sudoDeVinci/Cloud-Imager-VLSP/docs/pattern.png

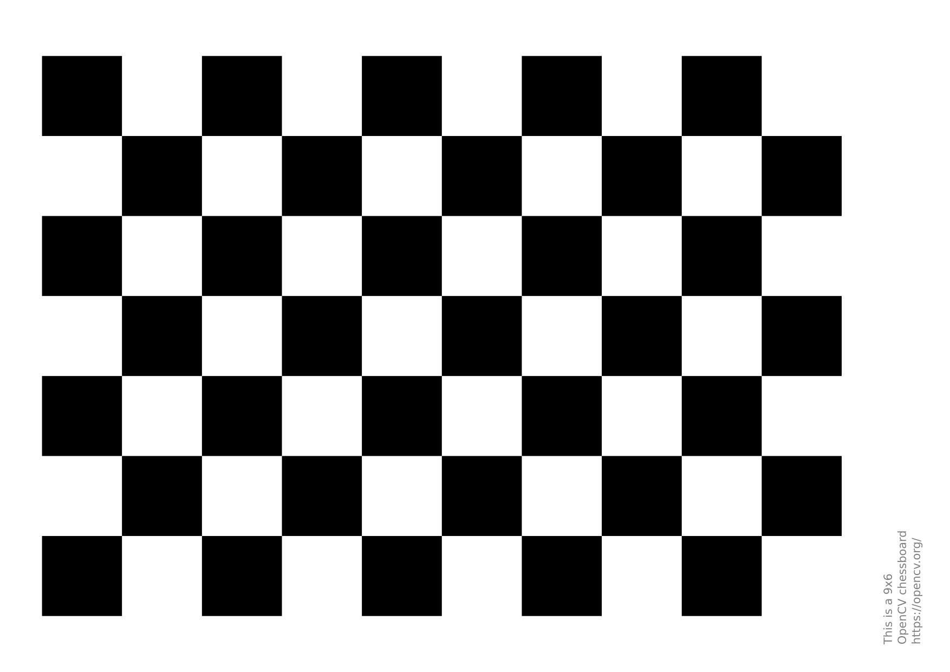
docs/pattern.png
