sudoDeVinci/Cloud-Imager-VLSP/Graphs/BGRPcaGraph-esp.png

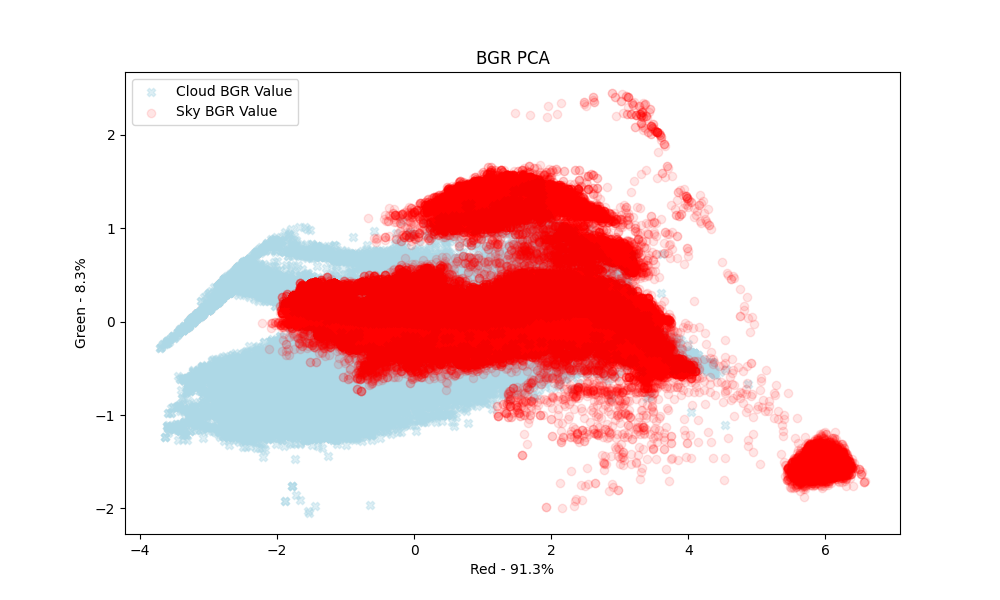
Graphs/BGRPcaGraph-esp.png
