sudoDeVinci/Cloud-Imager-VLSP/Graphs/BGRPcaGraph.png

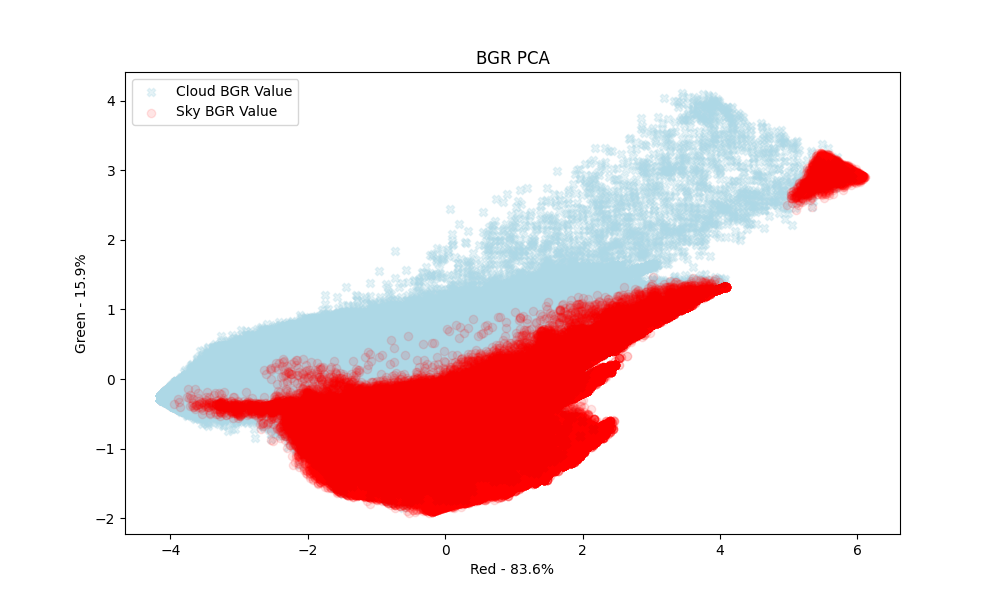
Graphs/BGRPcaGraph.png
