sudoDeVinci/Cloud-Imager-VLSP/Graphs/HSVBarGraph.png

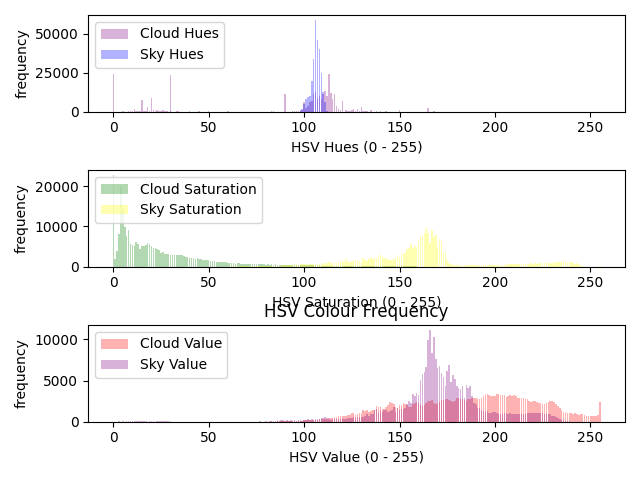
Graphs/HSVBarGraph.png
