sudoDeVinci/Cloud-Imager-VLSP/Graphs/HSVPcaGraph-esp.png

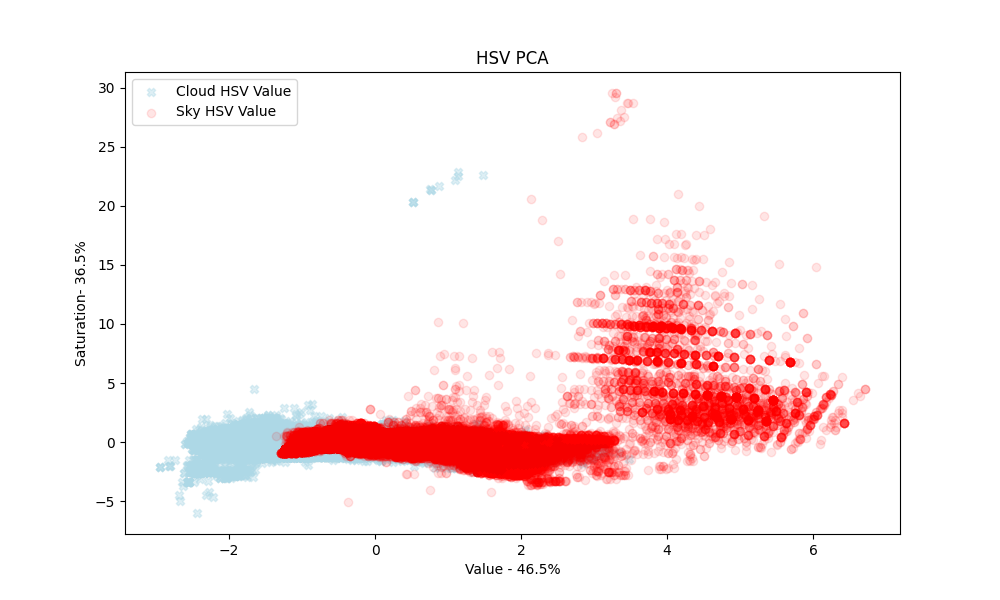
Graphs/HSVPcaGraph-esp.png
