sudoDeVinci/Cloud-Imager-VLSP/Graphs/HSVPcaGraph.png

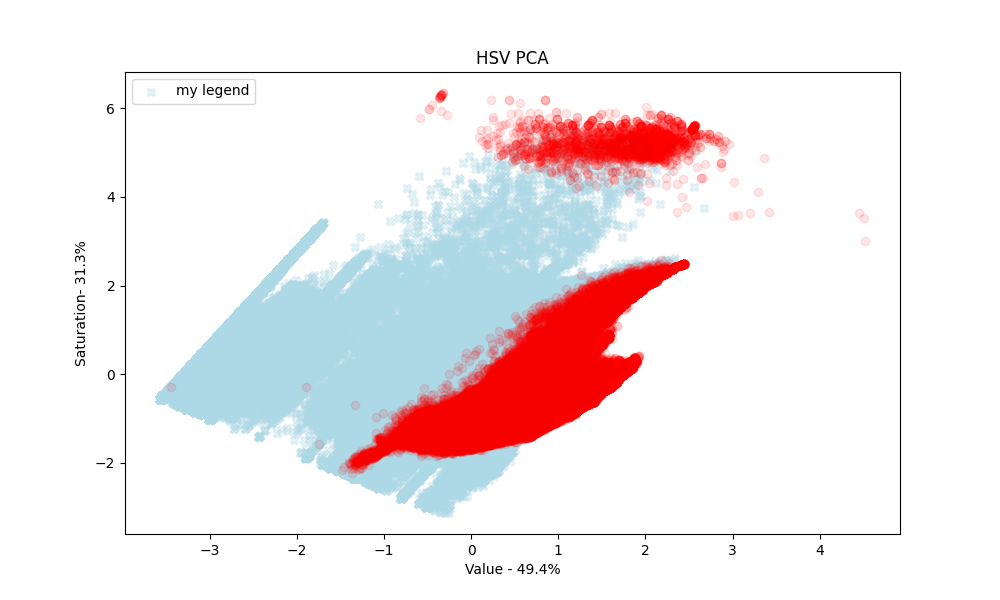
Graphs/HSVPcaGraph.png
