sudoDeVinci/Cloud-Imager-VLSP/Graphs/HSVScree-esp.png

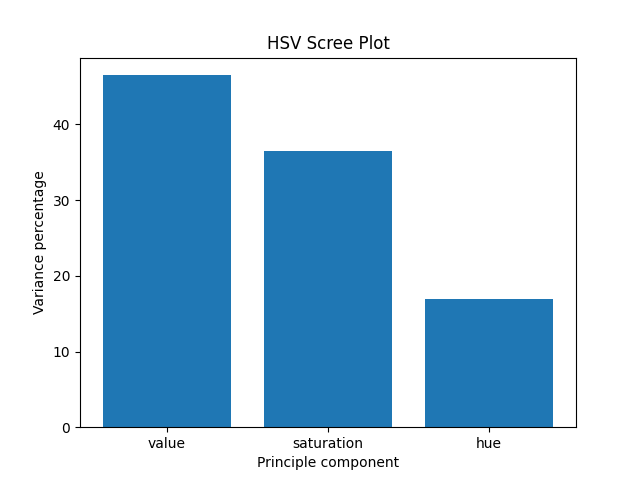
Graphs/HSVScree-esp.png
