sudoDeVinci/Cloud-Imager-VLSP/Graphs/HSVScree.png

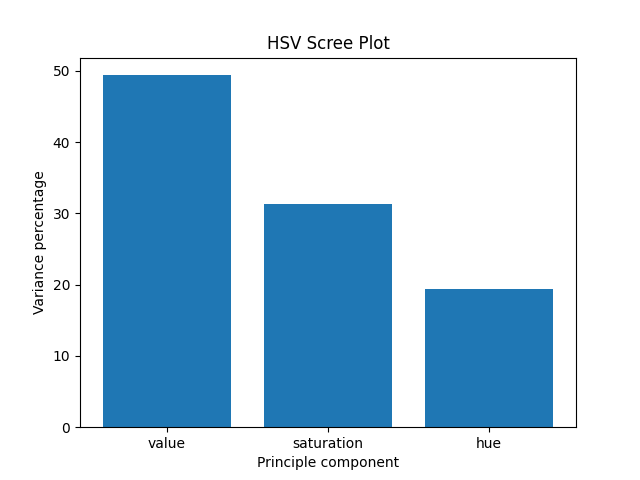
Graphs/HSVScree.png
