sudoDeVinci/Cloud-Imager-VLSP/onboard/sensors.cpp

#include "sensors.h"
#include "camera_pins.h"

float SEALEVELPRESSURE_HPA = UNDEFINED;

/**
 * Calculate the median of a sorted array.
 */
float median(float* sortedArray, int size) {
  if (size % 2 == 0) return (sortedArray[size / 2 - 1] + sortedArray[size / 2]) / 2.0;
  else return sortedArray[size / 2];
}

/**
 * Calculate mean of float array after removing outliers via IQR.
 */
float removeOutliersAndGetMean(float* dataArray, int dataSize) {
  // Sort the array
  float sortedData[dataSize];
  memcpy(sortedData, dataArray, dataSize * sizeof(float));
  std::sort(sortedData, sortedData + dataSize);

  // Calculate Q1 and Q3
  int Q1_index = dataSize / 4;
  int Q3_index = (3 * dataSize) / 4;
  float Q1 = median(sortedData, Q1_index == 0 ? 1 : Q1_index);
  float Q3 = median(sortedData + Q3_index, dataSize - Q3_index);

  // Calculate IQR
  float IQR = Q3 - Q1;

  // Define the lower and upper bounds for outliers
  float lowerBound = Q1 - 1.5 * IQR;
  float upperBound = Q3 + 1.5 * IQR;

  float sum = 0.0;
  int validCount = 0;

  // Calculate mean of non-outlier values
  for (int i = 0; i < dataSize; i++) {
    if (dataArray[i] >= lowerBound && dataArray[i] <= upperBound) {
      sum += dataArray[i];
      validCount++;
    }
  }

  return sum / validCount;
}

/**
 * Sleep for a specified number of minutes. 
 */
void deepSleepMins(float mins) {
  esp_sleep_enable_timer_wakeup(mins*60000000);
  esp_deep_sleep_start();
}

/**
 * Toggle the heater for the SHT31-D.
 */
void toggleHeater(Sensors::Status *stat, Adafruit_SHT31 *sht) {
  if(stat -> SHT) sht -> heater(!(sht -> isHeaterEnabled()));
}

/**
 * Setup the SHT31-D.
 */
void shtSetup(Sensors::Status *stat, Adafruit_SHT31 *sht) {
  if (!sht -> begin()) {
    stat -> SHT = false;
    if (sht -> isHeaterEnabled()) toggleHeater(stat, sht);
    debugln("Couldn't find SHT31");
  } else {
    stat -> SHT = true;
    debugln("SHT31 found!");
  }
}

/**
 * Setup and calibrate the BMP390.
 */
void bmpSetup(TwoWire *wire, Sensors::Status *stat, Adafruit_BMP3XX *bmp) {
  
  if (!bmp -> begin_I2C(0x77, wire)) {
    stat -> BMP = false;
    debugln("Couldn't find BMP390");
  } else {
    stat -> BMP = true;
    debugln("BMP found!");

    /**
     * Set up oversampling and filter initialization
     */
    bmp -> setTemperatureOversampling(BMP3_OVERSAMPLING_32X);
    bmp -> setPressureOversampling(BMP3_OVERSAMPLING_32X);
    bmp -> setIIRFilterCoeff(BMP3_IIR_FILTER_COEFF_127);
    bmp -> setOutputDataRate(BMP3_ODR_50_HZ);
  }
}

/**
 * Reset the display and set the text color to white.
 */
void resetDisplay(Adafruit_SSD1306 *display) {
  display -> clearDisplay();
  display -> setTextSize(1.75);
  display -> setTextColor(WHITE);
}

/**
 * Setup and calibrate the SSD1306 OLED.
 */
void displaySetup(Sensors::Status *stat, Adafruit_SSD1306 *display) {
  if (!display -> begin(SSD1306_SWITCHCAPVCC, 0x3C)) {
    debugln("Display allocation failed");
  } else {
    stat -> SCREEN = true;
    resetDisplay(display);
    debugln("Display Found!");
    display -> println("Welcome!");
    display -> display(); 
  }

}

/**
 * Display the readings on the OLED display.
 */
void displayReadings(Reading* readings, Adafruit_SSD1306 *display) {

  display -> setTextColor(WHITE, BLACK);

  display -> setCursor(50, 10);
  display -> println(readings -> temperature + " C");

  display -> setCursor(50, 22);
  display -> println(readings -> humidity + " %");

  display -> setCursor(50, 34);
  display -> println(readings -> pressure + " Pa");

  display -> setCursor(50, 46);
  display -> println(readings -> dewpoint + " C");

  display -> display();
}


/**
 * Show the status of the sensprs on the OLED display.
 */
void displayStatuses(Sensors::Status *stat, Adafruit_SSD1306 *display, const char* SSID) {
  if (!stat -> SCREEN) return ;

  display -> setTextSize(1.8);

  display -> setCursor(0, 10);
  if (stat -> BMP) display -> setTextColor(BLACK, WHITE);
  else display -> setTextColor(WHITE, BLACK);
  display -> println(" BMP ");
  display -> display();

  display -> setCursor(0, 22);
  if (stat -> SHT) display -> setTextColor(BLACK, WHITE);
  else display -> setTextColor(WHITE, BLACK);
  display -> println(" SHT ");
  display -> display();

  display -> setCursor(0, 34);
  if (stat -> CAM) display -> setTextColor(BLACK, WHITE);
  else display -> setTextColor(WHITE, BLACK);
  display -> println(" CAM ");
  display -> display();

  display -> setCursor(0, 46);
  if (stat -> WIFI) display -> setTextColor(BLACK, WHITE);
  else display -> setTextColor(WHITE, BLACK);
  display -> println(" WIFI");
  display -> display();
}


/**
 * Set up the camera. 
 */
void cameraSetup(Sensors::Status *stat) {

  debugln("Setting up camera...");

  camera_config_t config;
  config.ledc_channel = LEDC_CHANNEL_0;
  config.ledc_timer = LEDC_TIMER_0;
  config.pin_d0 = Y2_GPIO_NUM;
  config.pin_d1 = Y3_GPIO_NUM;
  config.pin_d2 = Y4_GPIO_NUM;
  config.pin_d3 = Y5_GPIO_NUM;
  config.pin_d4 = Y6_GPIO_NUM;
  config.pin_d5 = Y7_GPIO_NUM;
  config.pin_d6 = Y8_GPIO_NUM;
  config.pin_d7 = Y9_GPIO_NUM;
  config.pin_xclk = XCLK_GPIO_NUM;
  config.pin_pclk = PCLK_GPIO_NUM;
  config.pin_vsync = VSYNC_GPIO_NUM;
  config.pin_href = HREF_GPIO_NUM;
  config.pin_sscb_sda = SIOD_GPIO_NUM;
  config.pin_sscb_scl = SIOC_GPIO_NUM;
  config.pin_pwdn = PWDN_GPIO_NUM;
  config.pin_reset = RESET_GPIO_NUM;
  config.xclk_freq_hz = CAMERA_CLK;
  config.frame_size = FRAMESIZE_QHD;
  config.pixel_format = PIXFORMAT_JPEG;
  config.grab_mode = CAMERA_GRAB_LATEST; // Needs to be "CAMERA_GRAB_LATEST" for camera to capture.
  config.fb_location = CAMERA_FB_IN_PSRAM;
  config.jpeg_quality = 10;
  config.fb_count = 1;

  /** if PSRAM keep res and jpeg quality.
   * Limit the frame size & quality when PSRAM is not available
   */
  if(!psramFound()) {
    debugln("Couldn't find PSRAM on the board!");
    config.frame_size = FRAMESIZE_SVGA;
    config.fb_location = CAMERA_FB_IN_DRAM;
    config.jpeg_quality = 30;
  }

  /**
   * Initialize the camera
   */
  esp_err_t initErr = esp_camera_init(&config);
  if (initErr != ESP_OK) {
    debugf("Camera init failed with error 0x%x", initErr);
    debugln();
    stat -> CAM = false;
    return;
  }

  sensor_t * s = esp_camera_sensor_get();
  s->set_brightness(s, 0);     // -2 to 2
  s->set_contrast(s, 1);       // -2 to 2
  s->set_saturation(s, 0);     // -2 to 2
  s->set_special_effect(s, 0); // 0 to 6 (0 - No Effect, 1 - Negative, 2 - Grayscale, 3 - Red Tint, 4 - Green Tint, 5 - Blue Tint, 6 - Sepia)
  s->set_whitebal(s, 1);       // 0 = disable , 1 = enable
  s->set_awb_gain(s, 1);       // 0 = disable , 1 = enable
  s->set_wb_mode(s, 2);        // 0 to 4 - if awb_gain enabled (0 - Auto, 1 - Sunny, 2 - Cloudy, 3 - Office, 4 - Home)
  s->set_exposure_ctrl(s, 1);  // 0 = disable , 1 = enable
  s->set_aec2(s, 0);           // 0 = disable , 1 = enable
  s->set_ae_level(s, 0);       // -2 to 2
  s->set_aec_value(s, 300);    // 0 to 1200
  s->set_gain_ctrl(s, 1);      // 0 = disable , 1 = enable
  s->set_agc_gain(s, 0);       // 0 to 30
  s->set_gainceiling(s, (gainceiling_t)6);  // 0 to 6 (6 from "timelapse" example sjr, OK)
  s->set_bpc(s, 0);            // 0 = disable , 1 = enable
  s->set_wpc(s, 1);            // 0 = disable , 1 = enable
  s->set_raw_gma(s, 1);        // 0 = disable , 1 = enable
  s->set_lenc(s, 1);           // 0 = disable , 1 = enable
  s->set_hmirror(s, 0);        // 0 = disable , 1 = enable
  s->set_vflip(s, 1);          // 0 = disable , 1 = enable
  s->set_dcw(s, 1);            // 0 = disable , 1 = enable
  s->set_colorbar(s, 0);       // 0 = disable , 1 = enable

  delay(100);

  /**
   * Attempt to capture an image with the given settings.
   * If no capture, set camera status to false and de-init camera.
   */
  camera_fb_t *fb = NULL;
  fb = esp_camera_fb_get();
  if(!fb) {
    debugln("Camera capture failed");
    stat -> CAM = false;
    esp_err_t deinitErr = cameraTeardown();
    if (deinitErr != ESP_OK) debugf("Camera de-init failed with error 0x%x", deinitErr);
    debugln();
    esp_camera_fb_return(fb);
    return;
  } else {
    esp_camera_fb_return(fb);
  }
  
  debugln("Camera configuration complete!");
  stat -> CAM = true;
}

/**
 * De-initialize the camera.
 */
esp_err_t cameraTeardown() {
  esp_err_t err = ESP_OK;

  // Deinitialize camera
  err = esp_camera_deinit();

  // Display any errors associated with camera deinitialization
  if (err != ESP_OK) debugf("Error deinitializing camera: %s\n", esp_err_to_name(err));
  else debugf("Camera deinitialized successfully\n");
  
  debugln();
  return err;
}

/**
 * Read the humidity and temperature from the SHT-31D.
 */
void read(Adafruit_SHT31 *sht, float *out) {
  float h, t;
  for (int s = 0; s < SAMPLES; s++) {
    h += sht -> readHumidity();
    t += sht -> readTemperature();
  }
  if(!isnan(h)) out[0] = h/SAMPLES;
  if(!isnan(t)) out[1] = t/SAMPLES;
}

/**
 * Read the pressure and altitude from the BMP390 in and Pa and meters.
 */
void read(Adafruit_BMP3XX *bmp, double *out) {

  float* presses = new float[SAMPLES];
  float* altids = new float[SAMPLES];
  float* tempers = new float[SAMPLES];

  double pressure;
  double altitude;
  double temperature;
  
  if (! bmp -> performReading()) return;

  for (int s = 0; s < SAMPLES; s++) {
    presses[s] = bmp -> readPressure();
    altids[s] = bmp -> readAltitude(SEALEVELPRESSURE_HPA);
    tempers[s] = bmp -> readTemperature(); 
  }

  altitude = static_cast<double>(removeOutliersAndGetMean(altids, SAMPLES));
  pressure = static_cast<double>(removeOutliersAndGetMean(presses, SAMPLES));
  temperature = static_cast<double>(removeOutliersAndGetMean(tempers, SAMPLES));

  if(!isnan(pressure)) out[0] = pressure;
  if(!isnan(altitude)) out[1] = altitude;
  if(!isnan(temperature)) out[2] = temperature;
}

/**
 * Calculate dewpoint corrected for altitude. 
 */
String calcDP(double temperature, double humidity, double pressure, double altitude) {
    double alpha = ((MAGNUS_A * temperature) / (MAGNUS_B + temperature)) + log(humidity / 100.0);
    double dewPoint = (MAGNUS_B * alpha) / (MAGNUS_A - alpha);
    dewPoint = dewPoint - (altitude / 1000.0);
    return String(dewPoint);
}

/**
 * Read all sensors for info as Strings. 
 */
Reading readAll(Sensors::Status *stat, Adafruit_SHT31 *sht, Adafruit_BMP3XX *bmp) {
  Reading readings;

  double* pat = new double[3]{UNDEFINED, UNDEFINED, UNDEFINED};
  float* ht = new float[2]{UNDEFINED, UNDEFINED};

  if(stat -> BMP) read(bmp, pat);
  if(stat -> SHT) read(sht, ht);

  /**
  * Assign temperature. Ideally this is from the SHT.
  * In case the BMP is down, get from BMP.
  */
  double temperature;
  if (stat -> SHT && ht[1] != UNDEFINED) temperature = static_cast<double>(ht[1]);
  else if (stat -> BMP && pat[2] != UNDEFINED) temperature = pat[2];
  else temperature = UNDEFINED;

  double humidity = static_cast<double>(ht[0]);
  double pressure = pat[0];
  double altitude = pat[1];

  if (temperature != UNDEFINED &&
    humidity !=UNDEFINED &&
    pressure !=UNDEFINED && 
    altitude !=UNDEFINED) readings.dewpoint = calcDP(temperature, humidity, pressure, altitude);

  if(temperature != UNDEFINED) readings.temperature = String(temperature);
  if(humidity != UNDEFINED) readings.humidity = String(humidity);
  if(pressure != UNDEFINED) readings.pressure = String(pressure);
  
  return readings;
}

/**
 * Return string equivalent of float array of readings.
 */
String readingsToString(Reading* readings) {
  int length = readings -> timestamp.length() +
               readings -> temperature.length() +
               readings -> humidity.length() + 
               readings -> pressure.length() +
               readings -> dewpoint.length() + 4;
  
  String out;
  out.reserve(length);
  out.concat(readings -> timestamp + ",");
  out.concat(readings -> temperature + ",");
  out.concat(readings -> humidity + ",");
  out.concat(readings -> pressure + ",");
  out.concat(readings -> dewpoint);
  
  return out;
}

/**
 * Print the readings for the sensors.
 */
void printReadings(Reading* readings) {
  debug(readings -> temperature + " deg C | ");
  debug(readings -> humidity + " % | ");
  debug(readings -> pressure + " Pa | ");
  debug(readings -> dewpoint + " deg C | ");
  debugln();
}

/**
 * Convert a vector a Strings from a csv file to an array of readings.
 */
Reading* csvToReadings(std::vector<String*> csv) {
  Reading* readings = new Reading[csv.size()];

  for (int i = 0; i < csv.size(); i++) {
    String* row = csv[i];
    readings[i].timestamp = row[0];
    readings[i].temperature = row[1];
    readings[i].humidity = row[2];
    readings[i].pressure = row[3];
    readings[i].dewpoint = row[4];
  }

  return readings;
}
