sudoDeVinci/Cloud-Imager-VLSP/(commit log)

2023-08-27 switching to java for server stuff
2023-09-05 java server, esp32 done, making db manager
    [00_45_37.csv, 00_47_09.csv, 00_47_12.csv, 00_47_13.csv, 00_47_14.csv, 00_51_45.csv, 01_03_10.csv, 12_46_30.csv]
2023-09-08 eigenvectors and components printed
2023-09-27 using mysql connector
2023-10-10 changing main for socket use
2023-10-30 changes to memory leak fioxes
    [comm.cpp, comm.h]
2023-11-04 comm done, doing sensors
2023-11-29 files on board for home testing
2024-01-31 Server intergartion
    [00_45_37.csv, 00_47_09.csv, 00_47_12.csv, 00_47_13.csv, 00_47_14.csv, 00_51_45.csv, 01_03_10.csv, 12_46_30.csv]
2024-02-12 agremeement, calibration and manager changes
2024-02-18 camera calibration
2024-03-21 cleanup calibration
2024-04-30 calibration dir changes
2024-06-03 current state
2024-06-10 wont compile - no errors I can see.
    [comm.cpp, comm.h, io.h, onboard.ino, sensors.h]
